GadgetReboot/ATTiny_Tree/README.md

# ATTiny_Tree
ATTiny 85 based Neopixel WS2812B Christmas Tree
