GadgetReboot/ATTiny_Tree/KiCAD/readme.md

KiCAD Design files
V1.1 has a rotated battery to clear the obstacles blocking the battery on v1.0
