GadgetReboot/ATTiny_Tree/PCB_Footprint_List.png

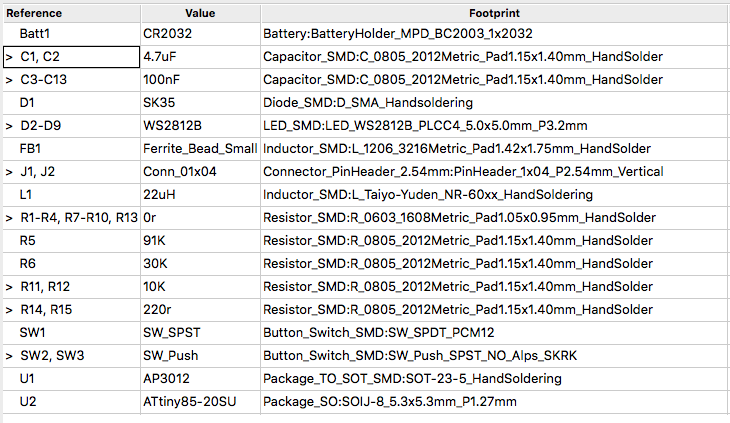
PCB_Footprint_List.png
