GadgetReboot/ATTiny_Tree/GR_ATTinyTree_1.0_Sch.pdf

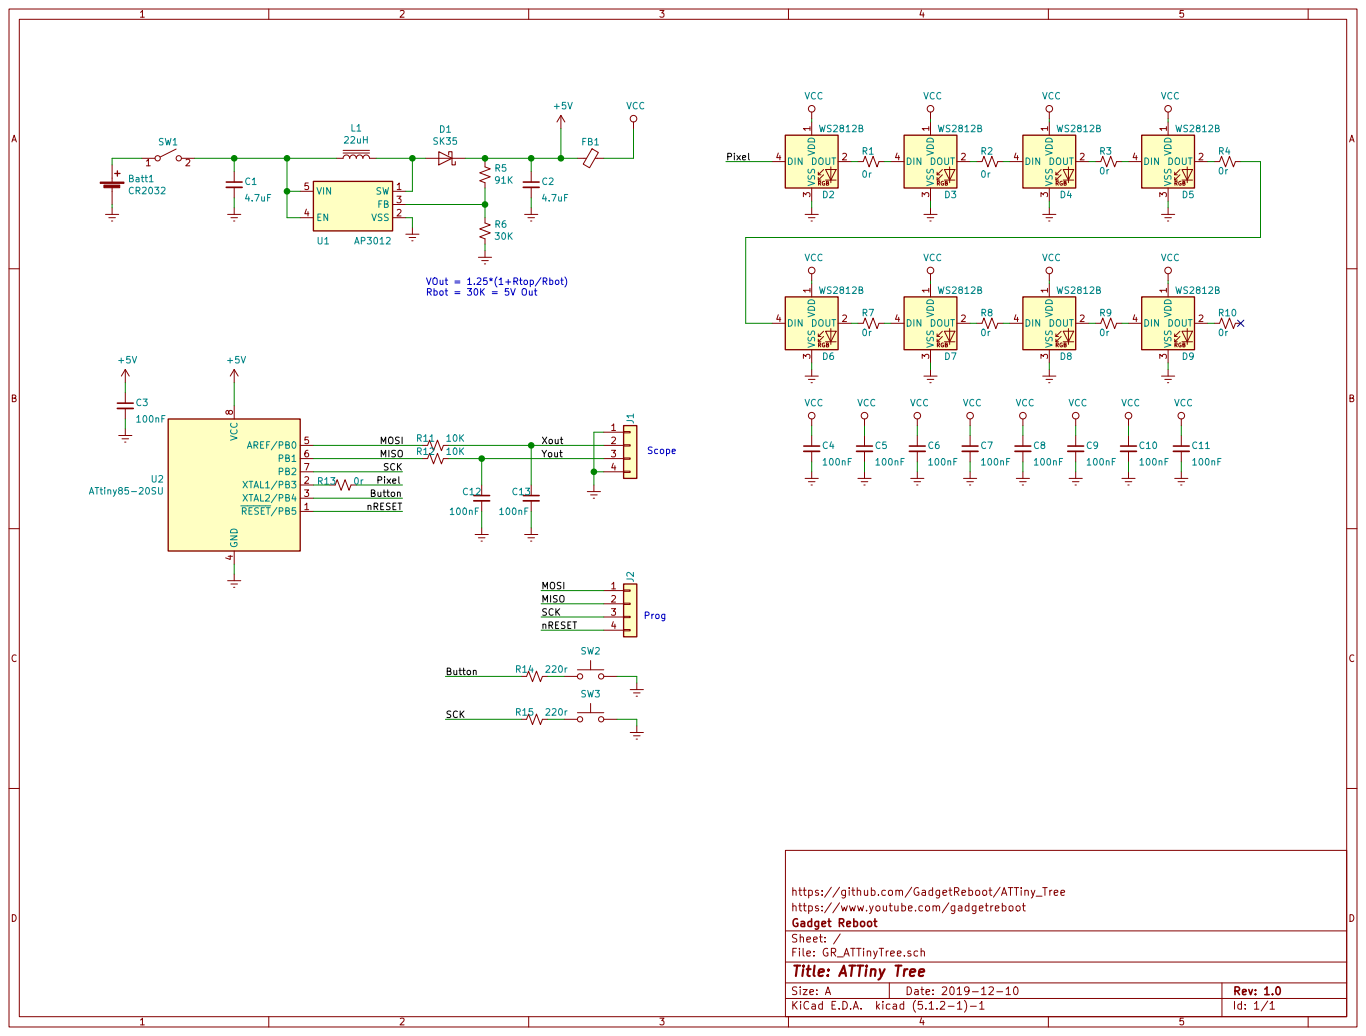
[picture p2: page 1]

nRESET Pixel MOSI MISO

https://github.com/GadgetReboot/ATTiny_Tree
https://www.youtube.com/gadgetreboot
File: GR_ATTinyTree.sch Sheet: / Gadget Reboot

Id: 1/1 Title: ATTiny Tree
