GadgetReboot/ATTiny_Tree/KiCAD/GR_ATTinyTree.kicad_pcb

## KiCad design KiCAD/GR_ATTinyTree.kicad_pcb (2019-12-24)

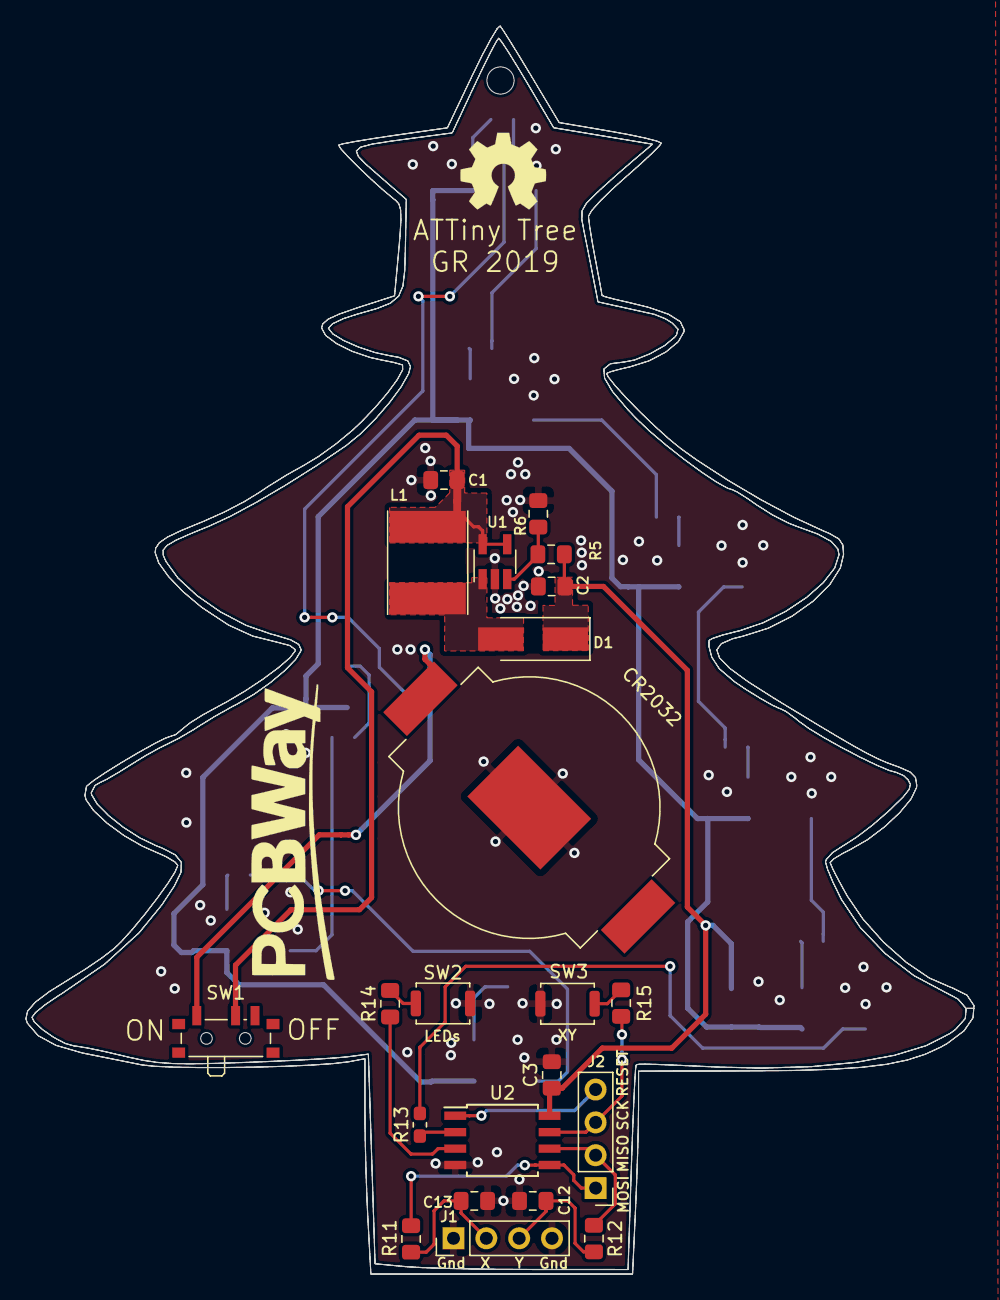
[picture p3: board GR_ATTinyTree.kicad_pcb from above]

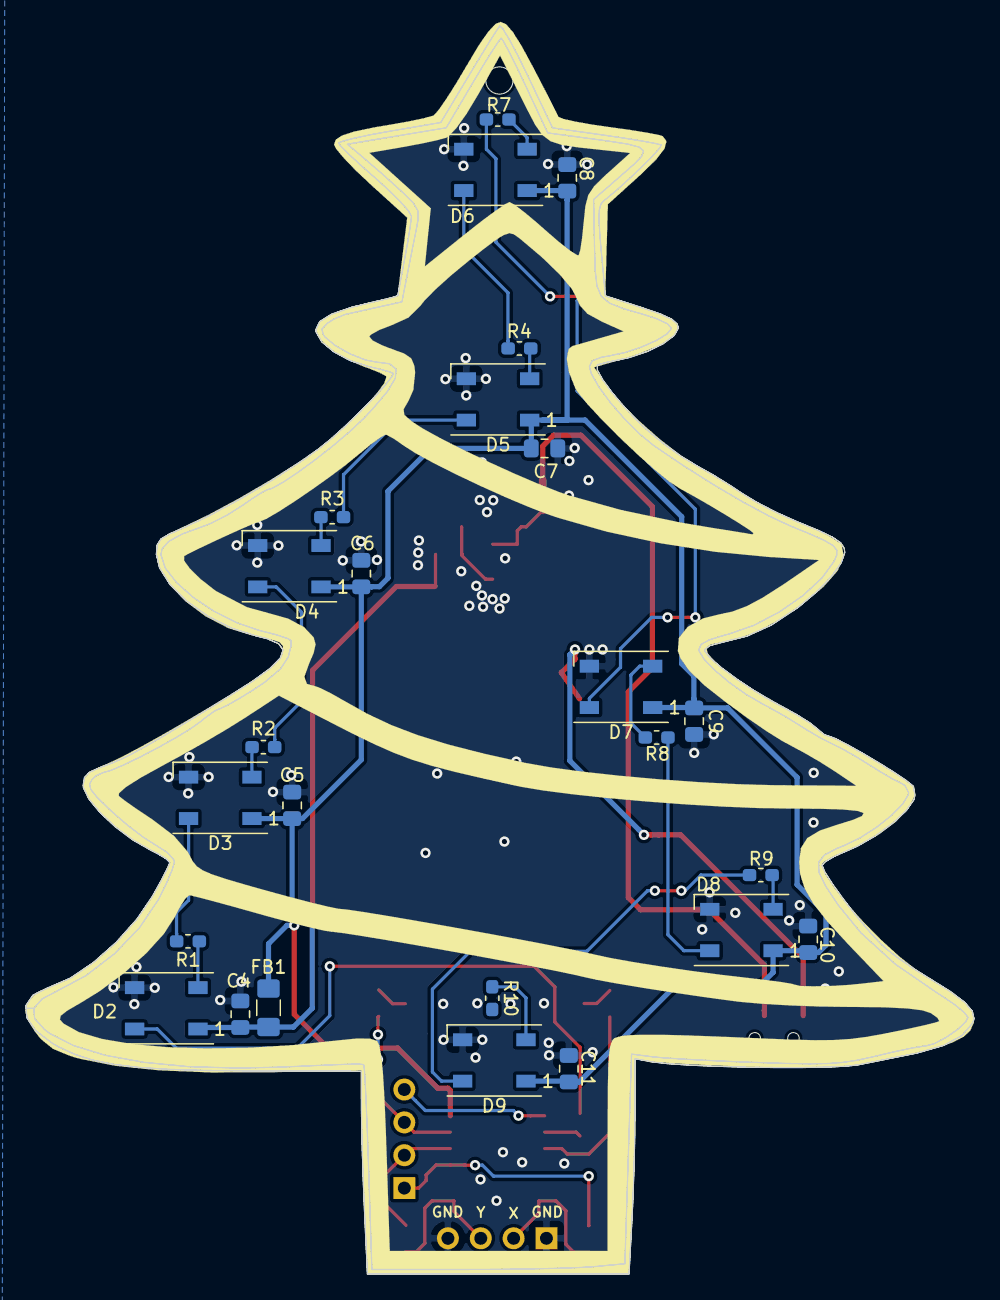
[picture p4: board GR_ATTinyTree.kicad_pcb from below]

Board: 2 copper layers, 73.3 x 96.6 mm, 47 parts (25 on the bottom side), 33 nets.

Parts:
Batt1: CR2032; BatteryHolder_MPD_BC2003_1x2032
C1, C2: 4.7uF; C_0805_2012Metric_Pad1.15x1.40mm_HandSolder
C3, C4, C5, C6, C7, C8, C9, C10, C11, C12, C13: 100nF; C_0805_2012Metric_Pad1.15x1.40mm_HandSolder
D1: SK35; D_SMA_Handsoldering
D2, D3, D4, D5, D6, D7, D8, D9: WS2812B; LED_WS2812B_PLCC4_5.0x5.0mm_P3.2mm
FB1: Ferrite_Bead_Small; L_1206_3216Metric_Pad1.42x1.75mm_HandSolder
J1, J2: Conn_01x04; PinHeader_1x04_P2.54mm_Vertical
L1: 22uH; L_Taiyo-Yuden_NR-60xx_HandSoldering
R1, R2, R3, R4, R7, R8, R9, R10, R13: 0r; R_0603_1608Metric_Pad1.05x0.95mm_HandSolder
R5: 91K; R_0805_2012Metric_Pad1.15x1.40mm_HandSolder
R6: 30K; R_0805_2012Metric_Pad1.15x1.40mm_HandSolder
R11, R12: 10K; R_0805_2012Metric_Pad1.15x1.40mm_HandSolder
R14, R15: 220r; R_0805_2012Metric_Pad1.15x1.40mm_HandSolder
SW1: SW_SPST; SW_SPDT_PCM12
SW2, SW3: SW_Push; SW_Push_SPST_NO_Alps_SKRK
U1: AP3012; SOT-23-5_HandSoldering
U2: ATtiny85-20SU; SOIJ-8_5.3x5.3mm_P1.27mm

Connections:
+5V: C2.1, C3.1, D1.1, FB1.2, R5.2, U2.8
/Button: R14.1, U2.3
/MISO: J2.2, R12.1, U2.6
/MOSI: J2.1, R11.1, U2.5
/Pixel: D2.4, R13.2
/SCK: J2.3, R15.1, U2.7
/Xout: C13.1, J1.2, R11.2
/Yout: C12.1, J1.3, R12.2
/nRESET: J2.4, U2.1
GNDREF: Batt1.2, C1.2, C2.2, C3.2, C4.2, C5.2, C6.2, C7.2, C8.2, C9.2, C10.2, C11.2, C12.2, C13.2, D2.3, D3.3, D4.3, D5.3, D6.3, D7.3, D8.3, D9.3, J1.1, J1.4, R6.1, SW2.2, SW3.2, U1.2, U2.4
unnamed: Batt1.1, SW1.1
unnamed: C1.1, L1.1, SW1.2, U1.4, U1.5
unnamed: D1.2, L1.2, U1.1
unnamed: D2.2, R1.1
unnamed: D3.2, R2.1
unnamed: D3.4, R1.2
unnamed: D4.2, R3.1
unnamed: D4.4, R2.2
unnamed: D5.2, R4.1
unnamed: D5.4, R3.2
unnamed: D6.2, R7.1
unnamed: D6.4, R4.2
unnamed: D7.2, R8.1
unnamed: D7.4, R7.2
unnamed: D8.2, R9.1
unnamed: D8.4, R8.2
unnamed: D9.2, R10.1
unnamed: D9.4, R9.2
unnamed: R5.1, R6.2, U1.3
unnamed: R13.1, U2.2
unnamed: R14.2, SW2.1
unnamed: R15.2, SW3.1
VCC: C4.1, C5.1, C6.1, C7.1, C8.1, C9.1, C10.1, C11.1, D2.1, D3.1, D4.1, D5.1, D6.1, D7.1, D8.1, D9.1, FB1.1
